AnaisLctr/Projet-elec/README.md

# Projet-elec
Projet électronique avec Emna

<h1>Présentation du projet :</h1>
<p>Le BaskoBolide est une petite voiture télécommandée via une appli, qui jette une balle (représentant une balle de basket), dans un panier de basket miniature, qui compte les paniers mis.</p>

<h1>Fonctionnalités :</h1>
Le projet se divise en 3 parties : 
<li>La voiture</li>
<li>Le panier</li>
<li>L’application du tel</li>

<h2>1- La voiture :</h2> 
<p>- lanceur de balle <br>
- se déplacer en roulant <br>
- changer de direction</p>

<h2>2- Le panier :</h2>
<p>- capteur de la balle<br>
- écran, compteur de panier mis<br>
( + led quand on marque )</p>

<h2>3- L’application qui dirige la voiture :</h2>
<p>- dirige la voiture Haut / bas / gauche / droite OU joystick<br>
- bouton qui permet à la voiture de lancer la balle</p>

<h1>Matériel :</h1>
2 Roues
1 petite roue
2 moteurs pour les roues
2 Moteurs pour le lanceur
1 pont
