AnaisLctr/Projet-elec/Le BaskoBolide - Soutenance.pdf

# Le BaskoBolide

Anaïs Lacouture | Emna Ben Khalifa

Projet Arduino Electronique

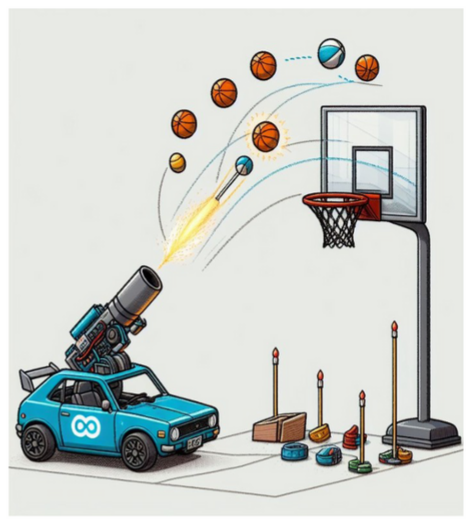
[picture p32: figure]

But du projet - Découvrir l’Arduino tout en s’amusant, en essayant de faire un super score

Idée du projet - Une Voiture télécommandée capable de tirer des balles de basket dans un panier de basket, qui compte le score.

Pourquoi ? - Fan de Basket, nous avons allié projet scolaire, sport et loisirs.

## Le Panier de Basket

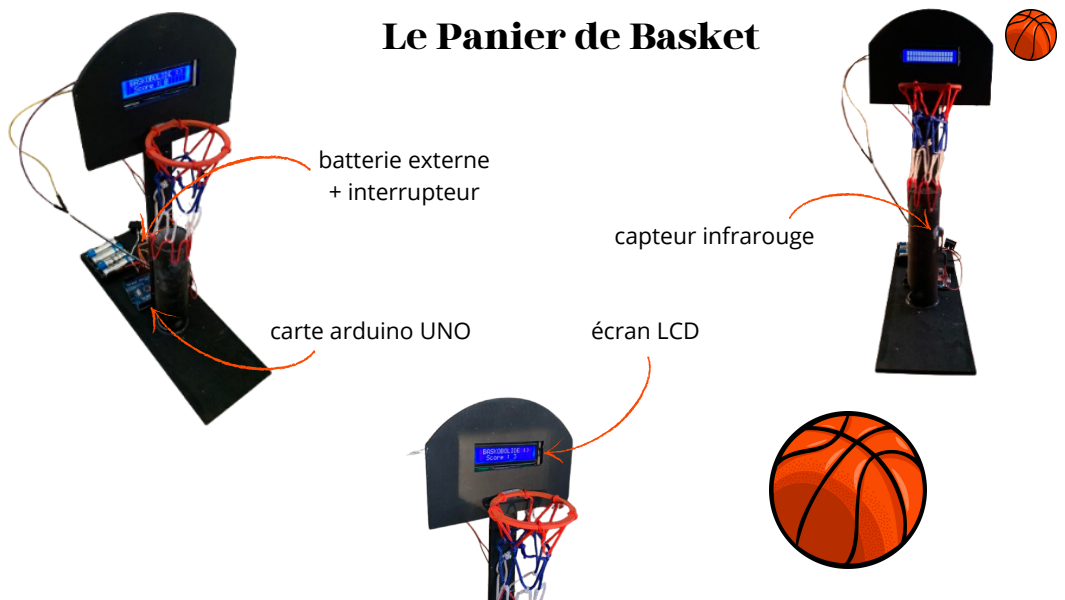
[picture p33: page 3]
écran LCD; capteur infrarouge; batterie externe + interrupteur

carte arduino UNO

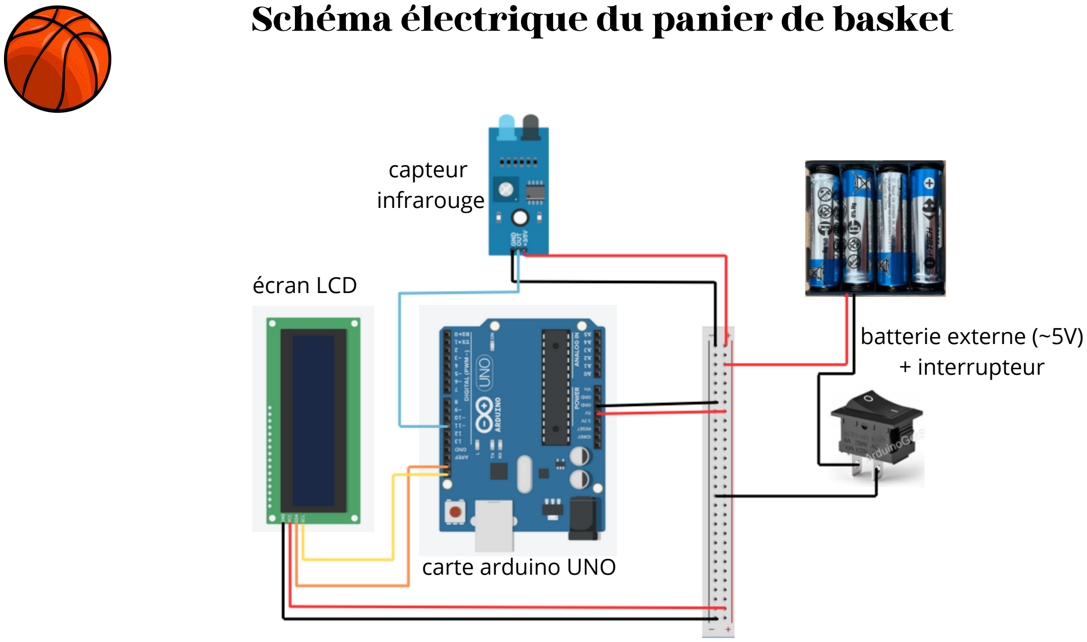
[picture p34: page 4]

Schéma électrique du panier de basket

écran LCD

capteur
infrarouge

batterie externe (~5V)
+ interrupteur

carte arduino UNO

## La Voiture

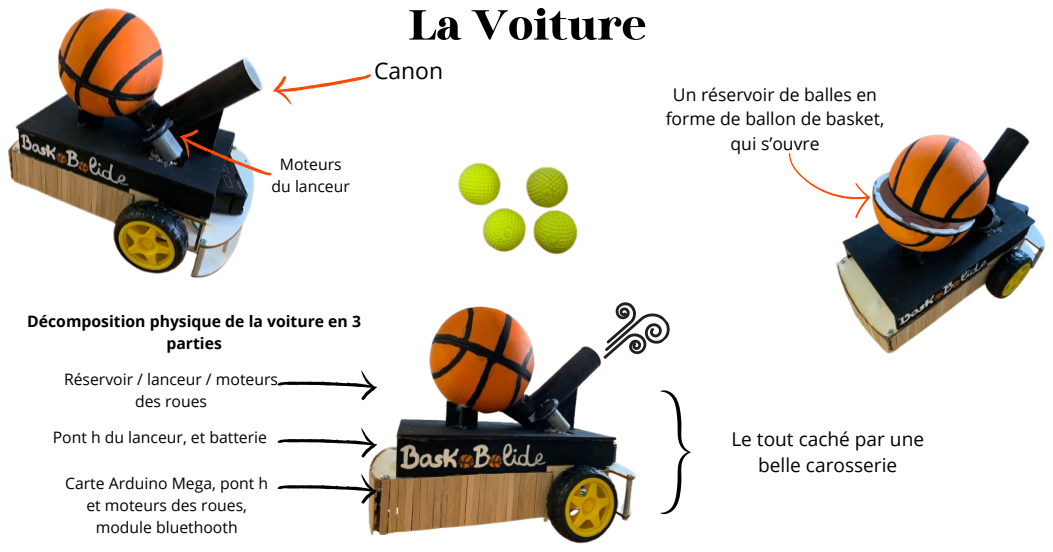
[picture p35: page 5]
Canon; Moteurs du lanceur; parties; des roues

Un réservoir de balles en
forme de ballon de basket,
qui s’ouvre

Décomposition physique de la voiture en 3

Réservoir / lanceur / moteurs

Pont h du lanceur, et batterie

Le tout caché par une
belle carosserie

Carte Arduino Mega, pont h
et moteurs des roues,
module bluethooth

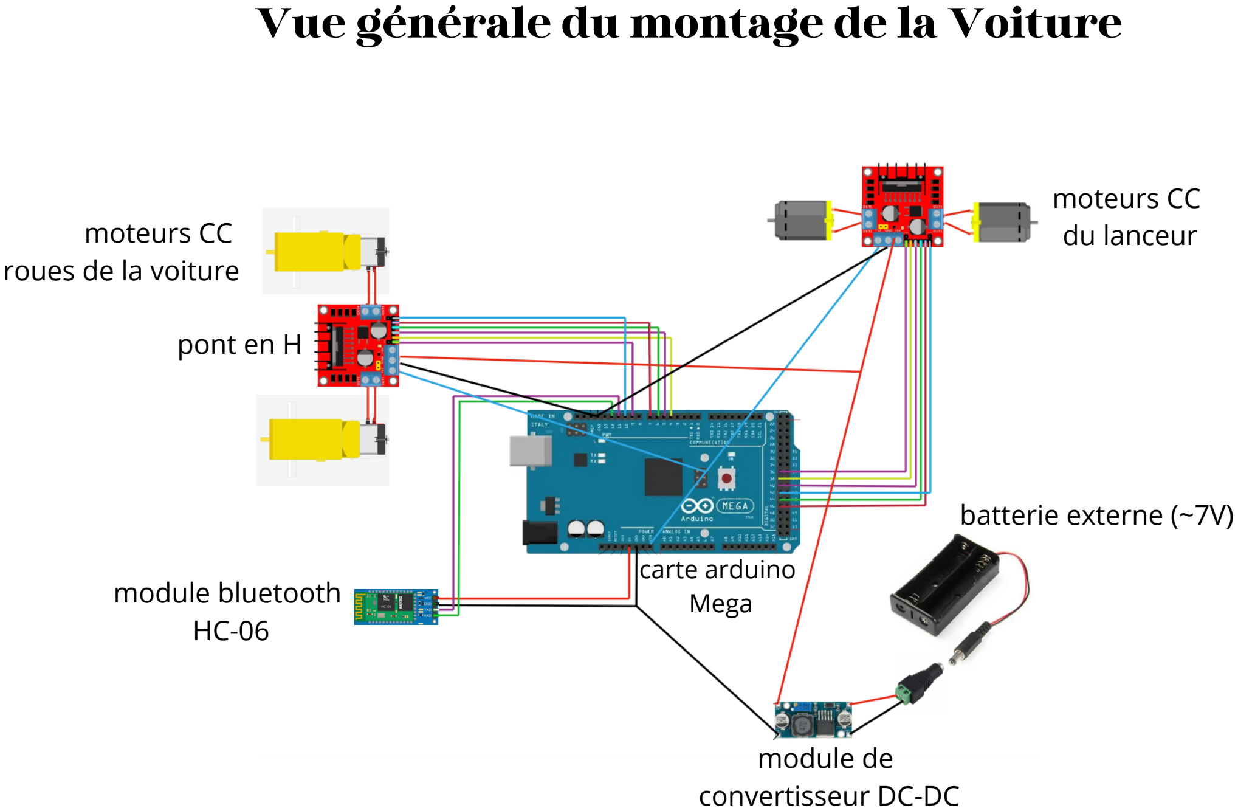
[picture p36: page 6]

Vue générale du montage de la Voiture

moteurs CC
roues de la voiture

pont en H

moteurs CC
du lanceur

module bluetooth
HC-06

batterie externe (~7V)

module de
convertisseur DC-DC

carte arduino
Mega

## Conclusion

Travail en équipe
Réflexion sur un projet
Défis techniques
Mise en place d’un projet de A à Z et donc respect d’un planning
