AnaisLctr/Projet-elec/Rapports séances /Emna/readme.md

Ce dossier contient tous les rapports de séance de Emna.
