AnaisLctr/Projet-elec/Rapports séances /Anaïs /readme.md

Ce dossier contient tous les rapports de séance de Anaïs Lacouture.
