AnaisLctr/Projet-elec/Rapports séances /Anaïs /rapport séance 4.pdf

# Rapport de séance 4 :

Faisons un point rapide sur notre planning de départ, et sur ce que nous avons respecté ou non.

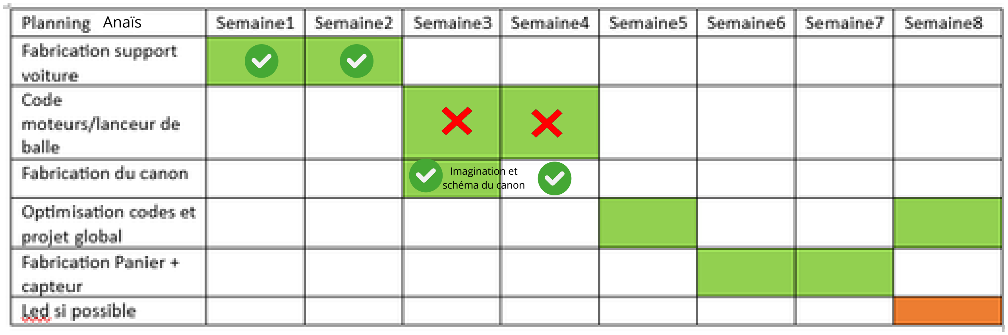
[picture p71: figure]
Anaïs; Imagination et schéma du canon
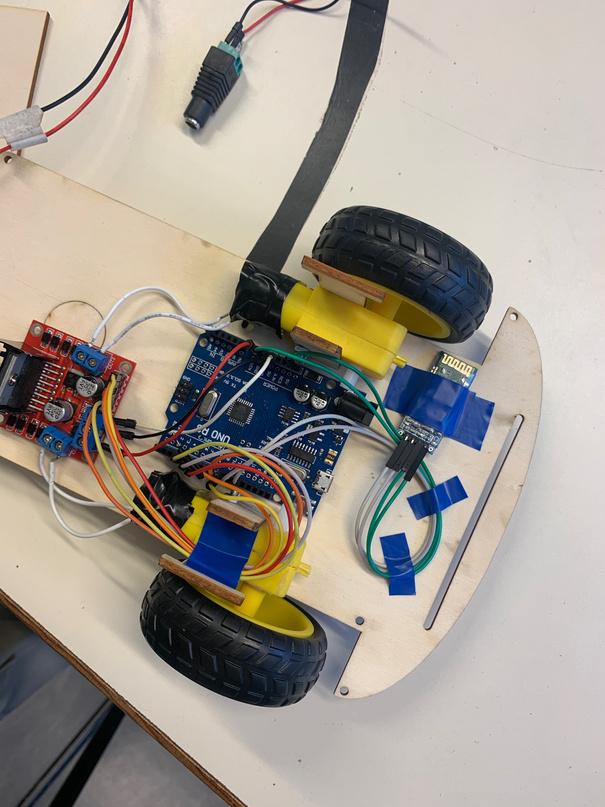
[picture p72: figure]
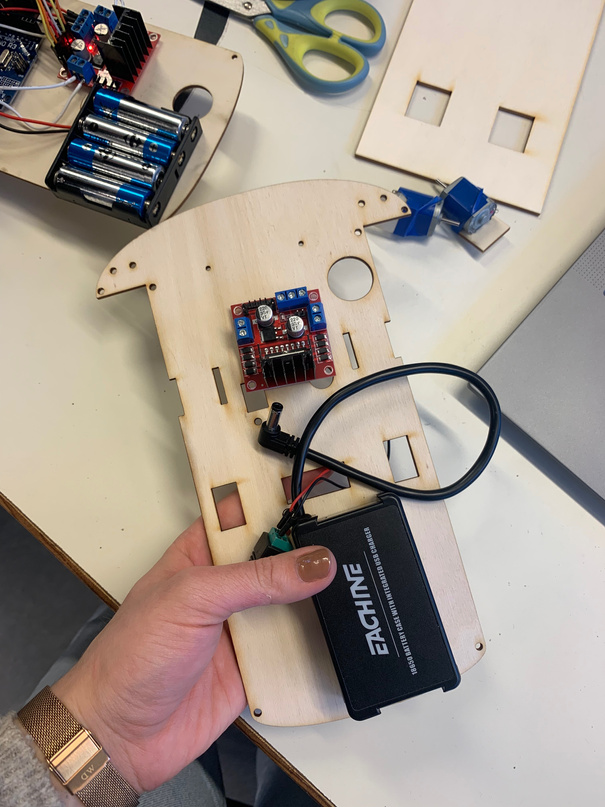
[picture p73: figure]
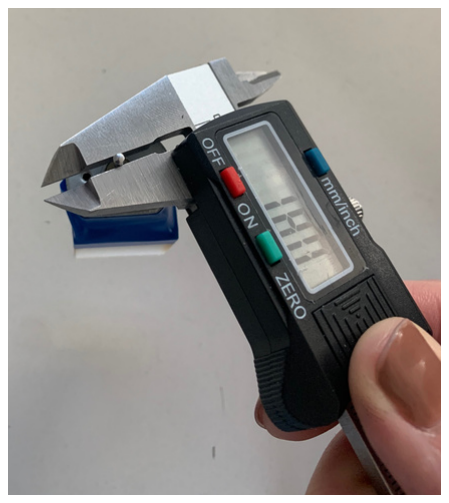
[picture p74: figure]

J’ai | fait | la
modélisation de la
roue (à imprimer
en 3D deux fois,
pour les moteurs
du lanceur), il a
fallu | que | je
mesure quelques
éléments sur les
moteurs.

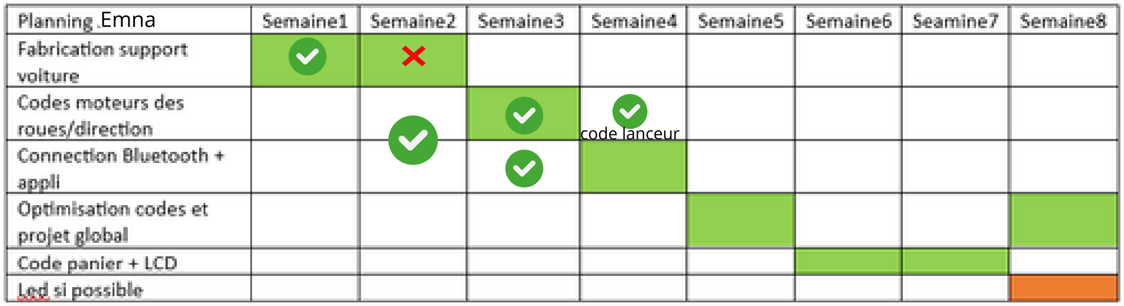
[picture p75: figure]
Emna; code lanceur
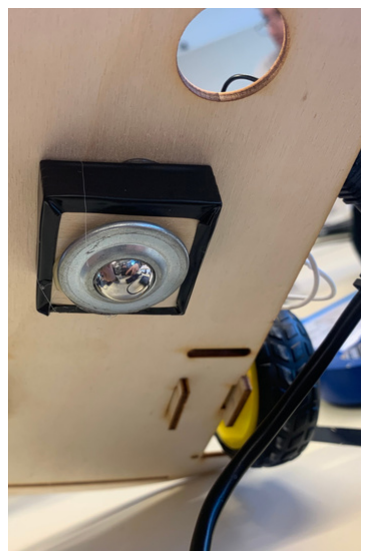
[picture p76: figure]

Nous avons fait notre oral de 10min.

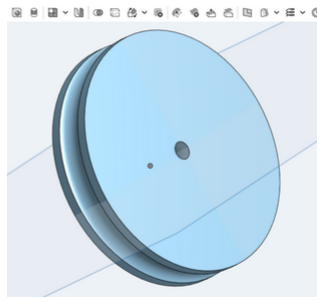
[picture p77: figure]
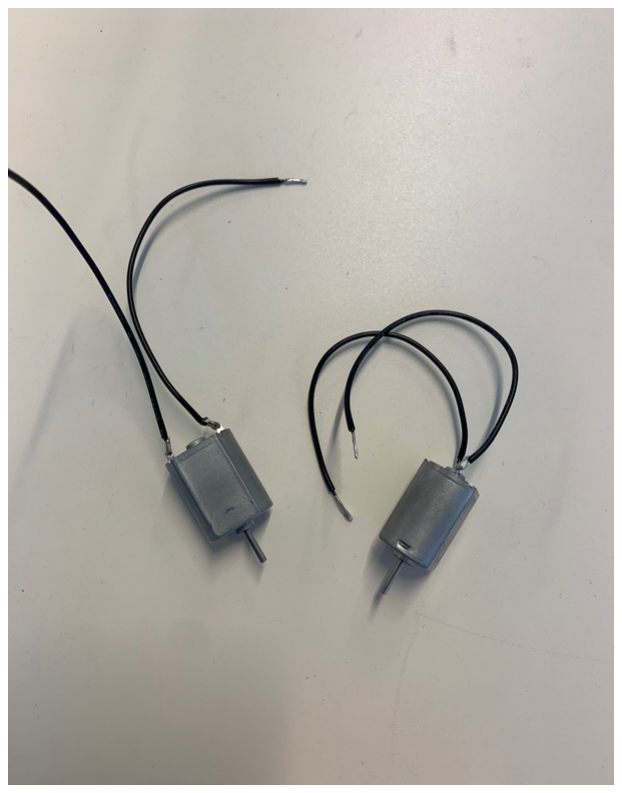
[picture p78: figure]

Pendant cette séance j’avais 3 tâches à effectuer mais qui seront sans doute retardées en fonction de la disponibilité de nos professeurs :
découper une planche en bois en tant que planche intermédiaire, de la taille du châssis, mais seulement avec les trous pour les vis, et un pour les câbles.
imprimer mes deux roues en 3D.
commander les joints toriques.
En attendant, je vais donc modéliser le canon en 3D et le réservoir.

Nous avons
tout d’abord
réparé la roue
de notre
voiture (collée
trop
faiblement)

Nous avons aussi fait du câble managment !

J’ai soudé les
fils aux
moteurs, au
moins ce sera
fait

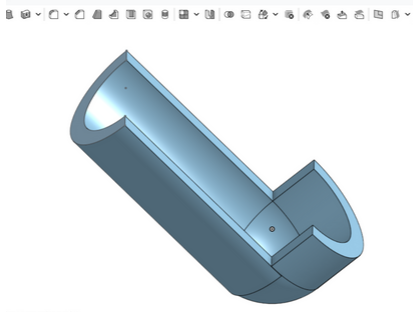
[picture p79: figure]

Pour l’instant j’ai donc crée la partie rampe du canon, que je modifierai certainement plus tard.
