AnaisLctr/Projet-elec/Rapports séances /Emna/Rapport séance 3.pdf

Pour cette 3ème séance, je me suis occupée du code de la voiture, que j’ai commencé durant la séance avant les vacances.

# RAPPORT SÉANCE 3

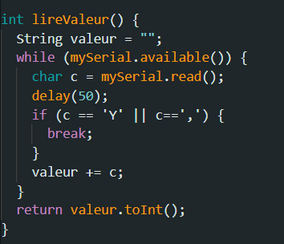
[picture p80: figure]
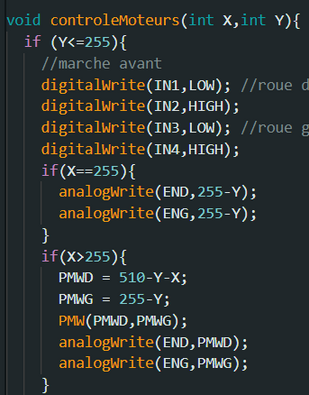
[picture p81: figure]
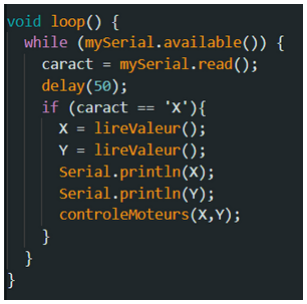
[picture p82: figure]
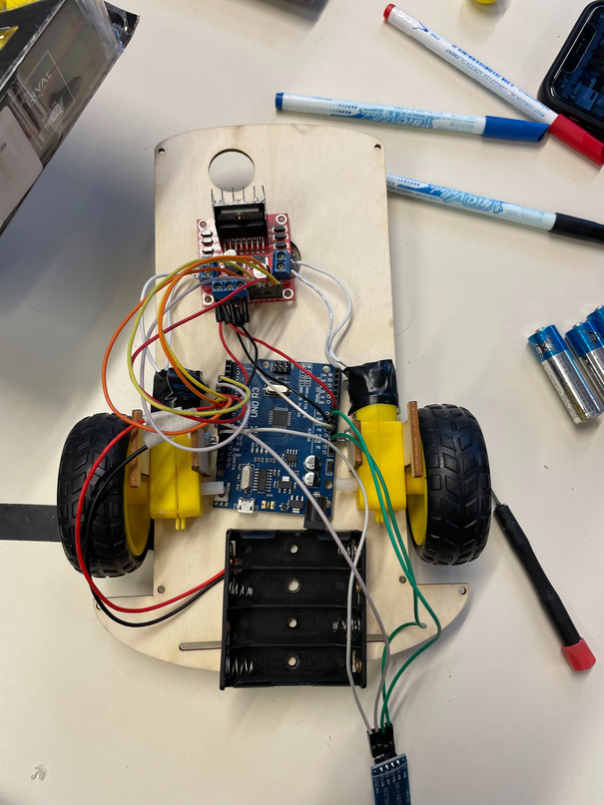
[picture p83: figure]

Après avoir fini le programme, j’ai voulu le tester avec notre voiture. J’ai donc branché les moteurs, le module bluetooth et une alimentation externe à la carte arduino.
Cependant, en téléversant le programme dans la carte arduino, les roues ne tournaient pas. Pour savoir si le problème venait de mon programme, je l’ai légèrement modifié pour faire fonctionner les moteurs :

J’ai écris deux méthodes :
- lireValeur() qui va permettre de récupérer, dans des variables X et Y, les coordonnées que le joystick nous renvoie.
- controleMoteurs(X,Y) qui, en fonction des valeurs récupérées, va changer la direction et la vitesse des moteurs. Pour cette méthode, j’ai dû faire plusieurs cas, en effet, le joystick fonctionne avec deux axes (X et Y). L’axe Y donne la direction des moteurs et avec l’axe Y, l’axe X contrôle la vitesse des moteurs et comme les valeurs de X et Y varie entre 0 et 511, il y a plusieurs calculs à faire en fonction des différents cas possible.

Enfin, j’ai appelée ces deux méthode dans le void loop() pour faire fonctionner les moteurs en fonction du joystick.

(une partie de la méthode controleMoteurs())

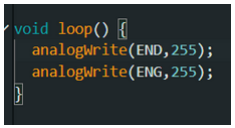
[picture p84: figure]

Malgré ces modification, les moteurs ne tournaient toujours pas. Au début je ne comprenais pas d’où venait le problème car avant de monter la voiture nous avions tester les moteurs et ils fonctionnaient correctement. Un des profs est donc venu m’aider, il a mesuré la tension au niveau de l’alimentation externe (support pour les piles) et du pont en H, où les moteurs étaient connectés et on s’est rendu compte que les piles ne fournissaient pas assez de tension pour faire fonctionner les moteurs. On a donc changer l’alimentation externe et on utilise maintenant des batteries en lithium qui fournissent beaucoup plus de puissance.

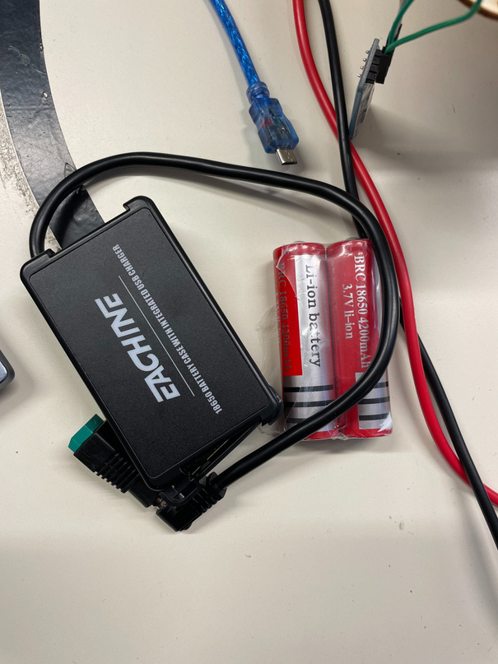
[picture p85: figure]
