AnaisLctr/Projet-elec/Rapports séances /Emna/Rapport séance 2.pdf

Pendant cette deuxième séance, nous avons continué à travailler sur la voiture.

# RAPPORT SÉANCE 2

J’ai commencé à faire le programme pour faire
rouler la voiture. Pour cela, j’ai récupérer des
programmes que nous avions fait en cours. Voici une partie du code :

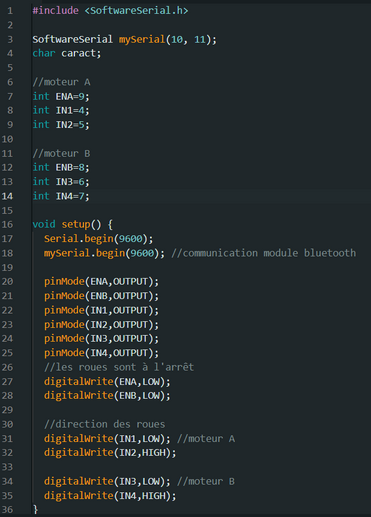
[picture p97: figure]

De plus, on voulait télécommander la voiture à distance donc on a décidé de le faire via une application, “bluetooth eletronics”, avec le bluetooth. J’ai récupérer un module bluetooth et, avant de coder la partie bluetooth avec l’application, j’ai configurer le module en utilisant encore une fois un code déjà fait en cours. Je lui ai donné un nom (“baskobolide”) et un code pin.

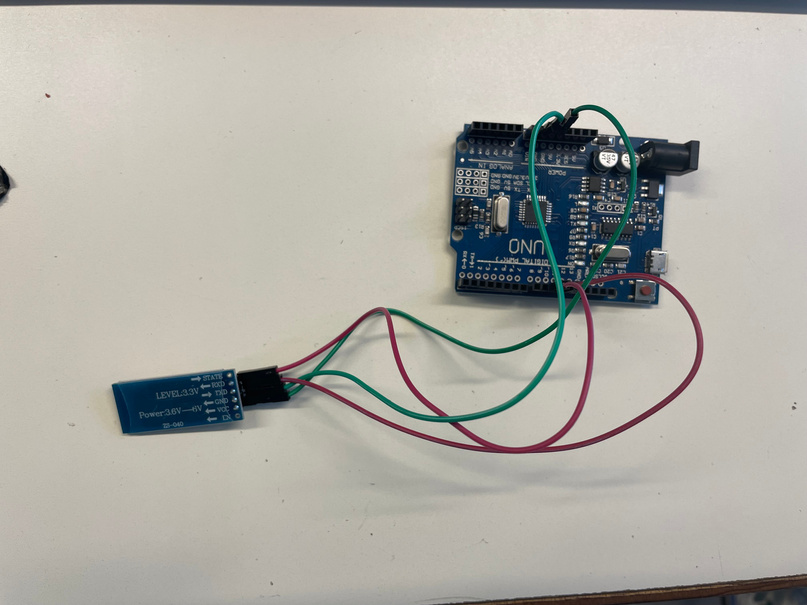
[picture p98: figure]

Une fois la configuration faite, on a dû choisir entre utiliser des flèches ou un joystick sur l’application pour contrôler la voiture mais on s’est dit que les mouvements de la voiture ne seraient pas assez fluides avec des flèches, donc on est partit sur un joystick. Pour savoir comment le joystick fonctionnait, j’ai écrit un code assez simple, ce qui m’a permis de voir ce qu’il me renvoyait exactement lorsque je l’utilisais sur l’application. Voici le code :

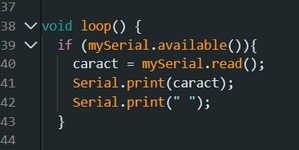
[picture p99: figure]

Le joystick fonctionne donc avec des coordonnées (x,y), et j’ai modifier les valeurs de x et y. Elles vont de 0 à 510 ce qui va simplifier les calculs pour la vitesse à laquelle les roues tournent.

Pendant ce temps, Anaïs a commencé à fabriquer la voiture et je l’ai un peu aidé à monter certaines pièces. Voici un aperçu de la voiture :

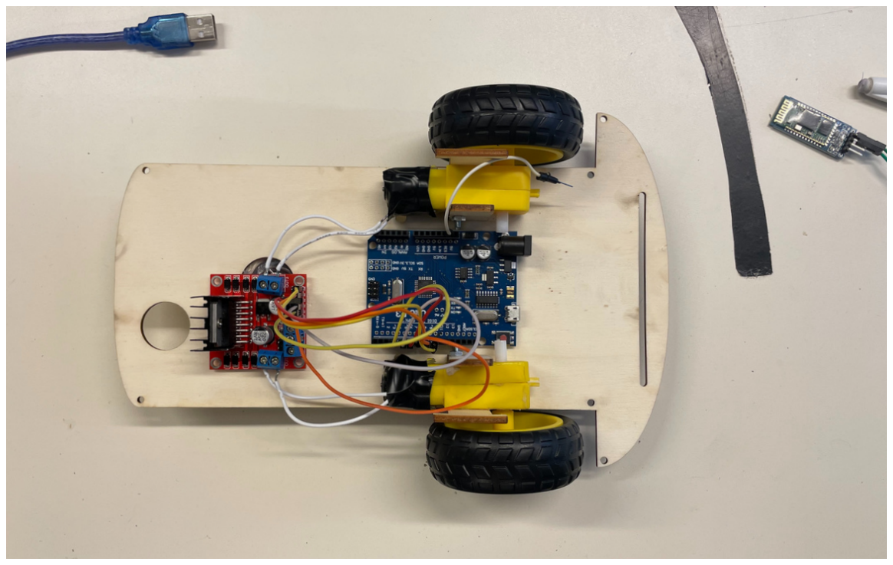
[picture p100: figure]

Je n’ai pas pu finir le code durant cette séance mais j’essayerais de le terminer avant le prochain cours pour pouvoir le tester avec la voiture et vérifier si il fonctionne.
