AnaisLctr/Projet-elec/planning Anaïs.png

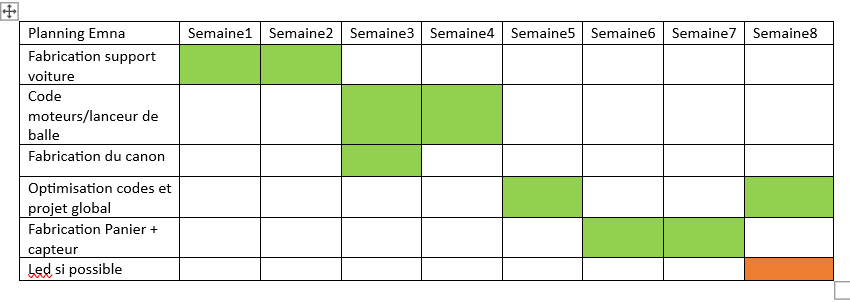
planning Anaïs.png
