AnaisLctr/Projet-elec/planning Emna .png

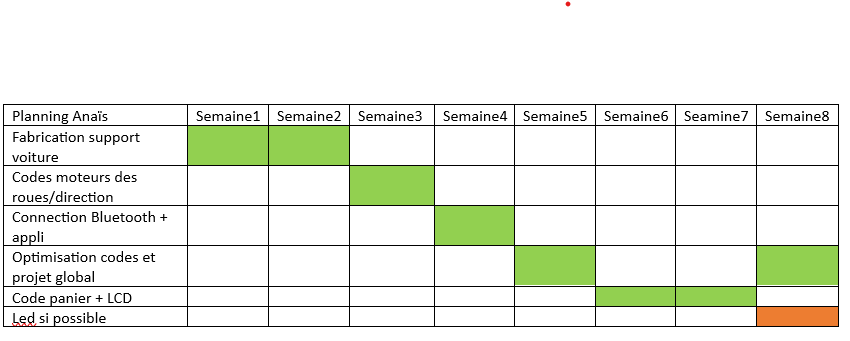
planning Emna .png
