AnaisLctr/Projet-elec/(commit log)

2024-01-15 Cahier des charges
2024-01-16 Rename Rapport de séance 4 .pdf to Rapport de séance 4 .pdf
2024-01-27 Rename Rapport de séance 4 .pdf to rapport de séance 4.pdf
2024-01-27 Rename rapport de séance 4.pdf to rapport séance 4.pdf
